Prrromanssss/iTablet/README.md

# iTablet

## Содержание

* [ВВЕДЕНИЕ](#введение)
* [ПЕРВЫЙ ЭТАП](#первый-этап)
  * [1.1 Влияние факторов, ограничивающих социальную коммуникацию](#11-влияние-факторов-ограничивающих-социальную-коммуникацию)
  * [1.2.  Проблематика и анализ доступных технологий для создания прототипа портативного устройства](#12-проблематика-и-анализ-доступных-технологий-для-создания-прототипа-портативного-устройства)
* [ВТОРОЙ ЭТАП](#второй-этап)
  * [2.1. Определение ресурсных затрат](#21-определение-ресурсных-затрат)
  * [2.2. Процесс создания прототипа портативного устройства для социальной коммуникации](#22-процесс-создания-прототипа-портативного-устройства-для-социальной-коммуникации)
  * [2.3. Демонстрация сборки и возможного практического применения прототипа](#23-демонстрация-сборки-и-возможного-практического-применения-прототипа)
  * [2.4. Возможное развитие и совершенствование прототипа.](#24-возможное-развитие-и-совершенствование-прототипа)
    * [2.4.1. Программно-аппаратные доработки](#241-программно-аппаратные-доработки)
    * [2.4.2. Расширение сфер применения](#242-расширение-сфер-применения)
    * [2.4.3. Апробация устройства](#243-апробация-устройства)
* [ВЫВОДЫ](#выводы)
* [ЛИТЕРАТУРА](#литература)
* [ПРИЛОЖЕНИЯ](#приложения)

## ВВЕДЕНИЕ

Речь ― *уникальный* инструмент коммуникации, присущий человеку, значение которого имеет важную роль в гармоничном развитии ребёнка. Через связь с окружающим миром дети учатся базовым социальным навыкам. Она способствует правильному развитию личности, способности к обучению сложным познавательным функциям. Учёные и педиатры выяснили, что отставание в речевом развитии ребёнка нередко сопровождается отставанием общего уровня развития. Механизм речи относится к высшим психическим функциям человека и напрямую зависит от развития центральной нервной системы (ЦНС).

К сожалению, существуют множество факторов, которые могут повлиять на способность ребёнка говорить. Педиатры выделяют следующие причины: патологии беременности и родов, генетические факторы, нарушения работы органа слуха, отсутствие или недостаток социального общения и воспитания. И если некоторые из них могут поддаваться лечению и терапии, то прочие навсегда способны полностью или частично лишить человека способности говорить.

Нарушения коммуникативных функций создают большие трудности в повседневной жизни для ребёнка и его близких. В ряде случаев ребёнок не способен ясно изложить просьбу в удовлетворении базовых физиологических потребностей. Отсюда возникает проблема в поиске средств коммуникации между ребёнком и взрослыми.

В эпоху повсеместного развития цифровой индустрии, в качестве доступного решения проблемы могут выступать портативные программируемые устройства, способные к модификации с учётом индивидуальных особенностей ребёнка.

Новизна обусловлена применением современных портативных устройств на основе бюджетных моделей для детей, испытывающих трудности социального взаимодействия.

Актуальность исследования заключается в возможности применения современных портативных электронных устройств на базе программируемых микроконтроллеров с визуально-звуковым подкреплением.

Целью работы является исследование технологий создания современных электронных устройств для детей, испытывающих трудности социального взаимодействия.

**Задачи проекта:**

* исследовать факторы, ограничивающих гармоничное развитие и оказывающих влияние на социальную коммуникацию детей и взрослых;
* проанализировать доступные технологии создания современных электронных устройств с визуально-звуковым подкреплением для детей, испытывающих трудности социальной коммуникации;
* описать процесс создания портативного электронного устройства на базе программируемого микроконтроллера;
* продемонстрировать возможное практическое применение прототипа.

На первом этапе исследуем факторы, ограничивающие гармоничное развитие и оказывающие влияние на социальную коммуникацию детей и взрослых и проанализируем доступные технологии создания портативных устройств, способных выступать инструментом социальной коммуникации.

На втором этапе опишем процесс создания электронного устройства на базе программируемого микроконтроллера и продемонстрируем возможное практическое применение прототипа.

## ПЕРВЫЙ ЭТАП

### 1.1 Влияние факторов, ограничивающих социальную коммуникацию

 Специалисты уверены, что задержка или отсутствие речевого развития у детей не является самостоятельным заболеванием. Механизм речи напрямую зависит от развития центральной нервной системы.

**Некоторые факторы, провоцирующие задержку речевого и психоречевого развития:**

* Болезни матери во время беременности. Нарушению развития плода могут способствовать проникновению инфекции, отравления, травмы.
* Кислородное голодание (гипоксия) плода в утробе матери.
* Тяжелые роды (стремительные, преждевременные, обвитие пуповины вокруг шеи), травма ребенка при родах (перинатальная энцефалопатия, травма ЦНС, шейных отделов позвоночника).
* Перенесение ребенком тяжелых инфекций (вызвавших заболевания мозга) и травм в раннем возрасте.
* Генетические, хромосомные заболевания, при которых нарушается структура мозга.
* Неправильное воспитание: ребенок растет под слишком сильной опекой или, наоборот, брошен на произвол судьбы, с ребенком дома жестоко обращаются. Нередко дети с ЗПРР выходят из асоциальных семей.
* Тяжелая психическая травма в раннем возрасте.

**Заболевания, провоцирующие задержку речевого и психоречевого развития:**

* врожденные аномалии ЦНС;
* эпилепсия и другие неврологические заболевания;
* ишемия головного мозга;
* гидроцефалия;
* повышенное внутричерепное давление;
* детский церебральный паралич;
* опухоль головного мозга;
* патологии сосудов головного мозга;
* лейкодистрофии;
* нарушение ликвородинамики.

Кроме того, не являются исключением и расстройства аутистического спектра.

Из всего вышеперечисленного видно, что существует множество факторов ограничивающих социальную коммуникацию ребёнка, а значит возникает потребность в комплексной поддержке специалистов и исследованиях возможности применения современных технологий и средств, компенсирующих данное явление.

### 1.2.  Проблематика и анализ доступных технологий для создания прототипа портативного устройства

Анализируя рынок устройств для альтернативной коммуникации детей, испытывающих трудности социального взаимодействия, нами были выявлены **ряд проблем**. К которым можно отнести:

* ценовой сегмент, не предлагающий бюджетных решений (устройства на основе планшетных компьютеров);
* возможность использования на таких устройствах приложений для развлечений, упреждающих возможность к быстрой коммуникации;
* нежелательное поведение без присмотра, актуальное для дорогостоящих устройств, имеющих выход в сеть интернет;
* способность к модификации с учётом индивидуальных особенностей ребёнка.

Примером такого устройства можно считать планшет-коммуникатор Tobii Dynavox Indi. Устройство представлено в высоком ценовом сегменте и является адаптивным планшетным компьютером.

В качестве решения данной проблемы, опишем возможность создания прототипа на основе доступных современных технологий.

За основу функционального устройства была выбрана форма планшета с матрицей кнопок (*Рисунок 1*). Каждая из кнопок содержит графическое изображение, отражающее базовую потребность (визуальное подкрепление) и голосовое дублирование (звуковое подкрепление).

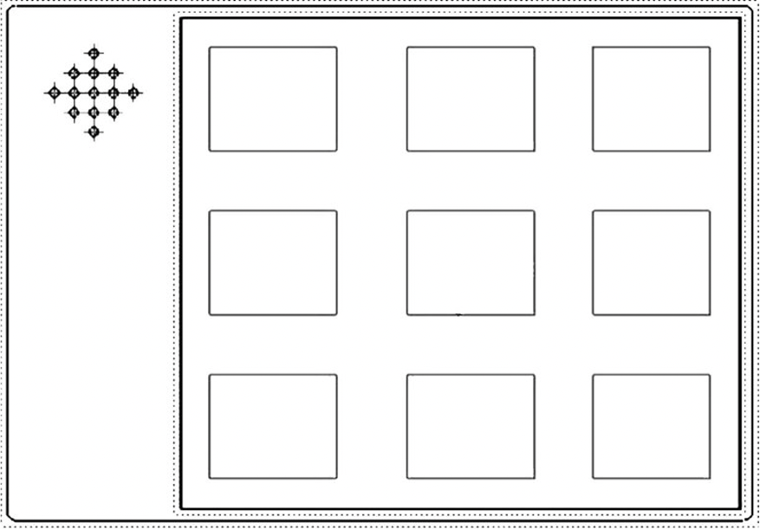
[picture p1: images/design_sketch.png]
Эскиз конструкции прототипа


<p align=center><i>Рис. 1. Эскиз конструкции прототипа</i></p>

Для создания устройства данного типа необходимо определить среду разработки. Остановим наш выбор на Arduino. Наш выбор обусловлен доступностью, обширным количеством документации и библиотек. Данная среда разработки поддерживает множество различных программно-аппаратных решений на основе программируемых микроконтроллеров.

Для расширения функционала и обеспечения удалённой коммуникации, в качестве примера, было решено дополнить устройство возможностью дублировании команд в популярном мессенджере. Чтобы воплотить данную задачу было решено использовать плату типа ESP8266. Её функционал позволяет осуществлять связь между устройствами по средствам локальных персональных сетей с использованием технологии Wi-Fi.

Плата ESP8266 имеет **несколько модификаций**:

* Wemos D1 mini;
* Wemos D1 R2;
* Wemos D1 R1.

Наиболее популярной версией является R2. Стоимость R1 немного ниже. Отличие первого от второго поколения не очень большие и касаются, в первую очередь, распиновки, однако обе модели подходят под наше устройство. По сравнению с Wemos D1 R1/R2, микроконтроллер WeMos D1 Mini имеет меньшие габариты, что сказалось на распиновке, которая не подходит для нашего устройства из-за маленького количества цифровых контактов. Чтобы выполнить все задачи, поставленные в проекте, было решено использовать Wemos D1 R1, выбор обусловлен доступностью.

Для обеспечения заявленного звукового подкрепления необходимо наличие звукового модуля. Среди популярных решений можно встретить следующие **модели**:

* модуль wtv020sd16p, поддерживающий карты памяти microSD объёмом до 2 гигабайт и имеющий ограничения в чтении популярных форматов аудиофайлов. Мало популярный формат .ad4 требует необходимости в использовании дополнительного программного обеспечения для конвертации звуковых файлом;
* модуль DFPlayer mini mp3, поддерживающий популярный стандарт расширения .mp3, поддерживающий карты памяти объёмом до 32 гигабайт и объективную файловую систему типа FAT.

*Очевидно*, что модуль DFPlayer преимущественно выгоднее своего аналога wtv020sd16p.

 В качестве звуковоспроизводящего устройства подойдёт любой аудио-динамик (спикер) заявленной мощностью 0.5W 8 Ом и радиусом 50мм.

Выбор мессенджера, обеспечивающего удалённую коммуникацию, не является принципиальным вопросом, поскольку роль его сводится лишь в дублировании команд, отправляемых с портативного устройства. В нашей работе был выбран популярный мессенджер Telegram, предлагающий большой функционал и удобный способ разработки.

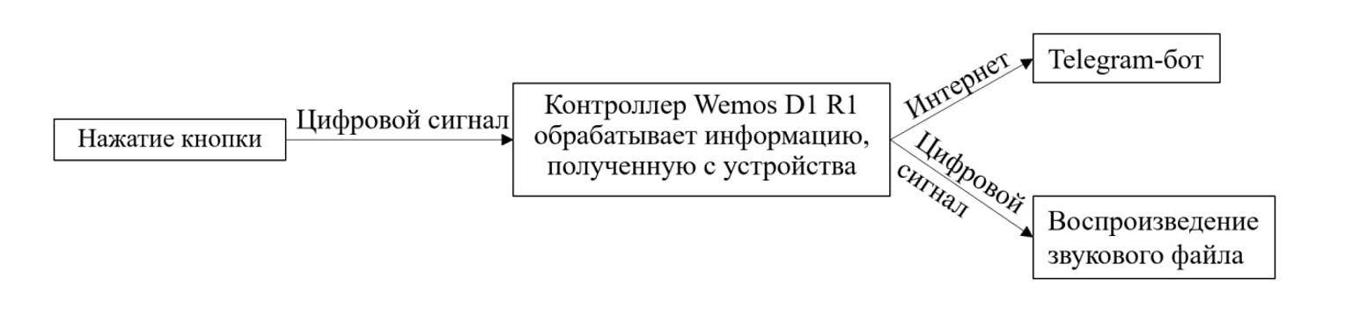
[picture p2: images/data_transmission_scheme.png]
Схема передачи данных


<p align=center><i>Рис. 2. Схема передачи данных</i></p>

## ВТОРОЙ ЭТАП

### 2.1. Определение ресурсных затрат

Корпус и механические части изделия были созданы с использованием технологии послойной 3D печати пластиком типа PLA с диаметром нити 1,75 миллиметров. С описание печатных элементов изделия можно ознакомиться в *Приложении 1*.

Питание микроконтроллера будет осуществляться с помощью литий-полимерного аккумулятора на 5В. Его емкость составляет 5000 мАч. Данного объёма хватит для продолжительной работы устройства.

Со списком необходимых электронных деталей можно ознакомиться в *Приложении 2*.

<p align=right><i>Таблица стоимости деталей</i></p>

<p align=center>
    <table>
        <tr>
            <th>Номер</th>
            <th>Элемент</th>
            <th>Цена</th>
        </tr>
        <tr>
            <th>№ 1</th>
            <th>Плата WeMos D1 R1 с программируемым микроконтроллером ESP8266;</th>
            <th>300 ₽</th>
        </tr>
        <tr>
            <th>№ 2</th>
            <th>Звуковой модуль DFPlayer Mini MP3 3,5V;</th>
            <th>200 ₽</th>
        </tr>
        <tr>
            <th>№ 3</th>
            <th>Карта памяти microSD для хранения файлов, используемых DFPlayer Mini MP3;</th>
            <th>300 ₽</th>
        </tr>
        <tr>
            <th>№ 4</th>
            <th>Соединительные провода;</th>
            <th>400 ₽</th>
        </tr>
        <tr>
            <th>№ 5</th>
            <th>Тактовая кнопка, 8 штук;</th>
            <th>650 ₽</th>
        </tr>
        <tr>
            <th>№ 6</th>
            <th>Аудио-динамик 0.5W 8Ом 50мм;</th>
            <th>150 ₽</th>
        </tr>
        <tr>
            <th>№ 7</th>
            <th>Резисторы 2-2.2 кОм;</th>
            <th>50 ₽</th>
        </tr>
        <tr>
            <th>№ 8</th>
            <th>Литий-полимерный аккумулятор 5 В, 1.5 А, 5000 мАч для питания WeMos D1 R1;</th>
            <th>1000 ₽</th>
        </tr>
        <tr>
            <th>№ 9</th>
            <th>Переключатель движковой SS12D10;</th>
            <th>50 ₽</th>
        </tr>
        <tr>
            <th>№ 10</th>
            <th>Пластик.</th>
            <th>800 ₽</th>
        </tr>
    </table>
</p>

*Итого: 3900 ₽*

### 2.2. Процесс создания прототипа портативного устройства для социальной коммуникации

Для моделирования электрической схемы устройства воспользуемся сервисом KiCad (*Рисунок 3*). Этот сервис совмещает в себе возможность просмотра, создания и редактирования печатных плат. Среди аналогов является самым популярным и используемым. Для создания электрический схемы предоставляет весь необходимый функционал.

Далее, необходимо выполнить загрузку программного обеспечения, выполняющего управление работой платы WeMos D1 R1. Так как система Arduino-совместима, то все ее программирование будет проходить в среде разработки Arduino IDE. Для работы со звуковым модулем необходимо установить библиотеку Software.Serial, обеспечивающую прием и передачу данных от платы к модулю (порты RX и TX соответственно), а также библиотеку DFPlayerMini_Fast для инициализации модуля и воспроизведение файлов.

С листингом кода программы можно ознакомиться в файле iTablet_soft.ino.

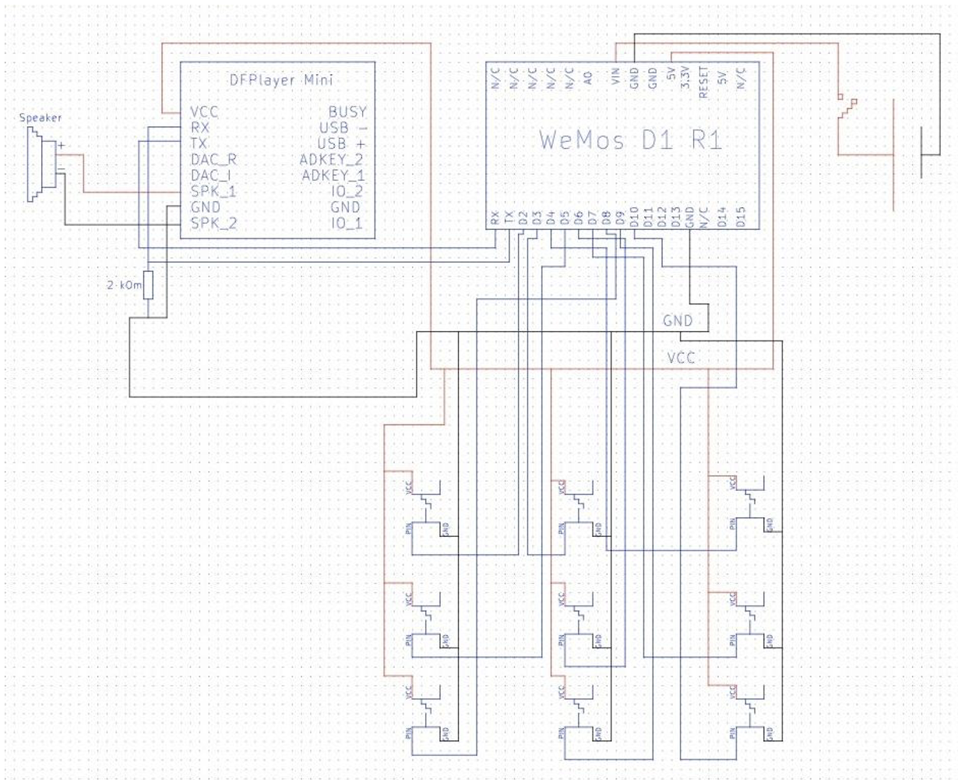
[picture p3: images/principal_scheme.png]
Принципиальная схема устройства


<p align=center><i>Рис. 3. Принципиальная схема устройства</i></p>

### 2.3. Демонстрация сборки и возможного практического применения прототипа

Руководствуясь принципиальной схемой, выполним сборку электронных элементов устройства (*Рисунок 4*).

Для питания платы соединим ее с аккумулятором, далее подготовим звуковой модуль для подключения к WeMos D1 R1. Для этого нам потребуется припаять плюс и минус динамика к соответствующим пинам модуля DFPlayer Mini MP3.

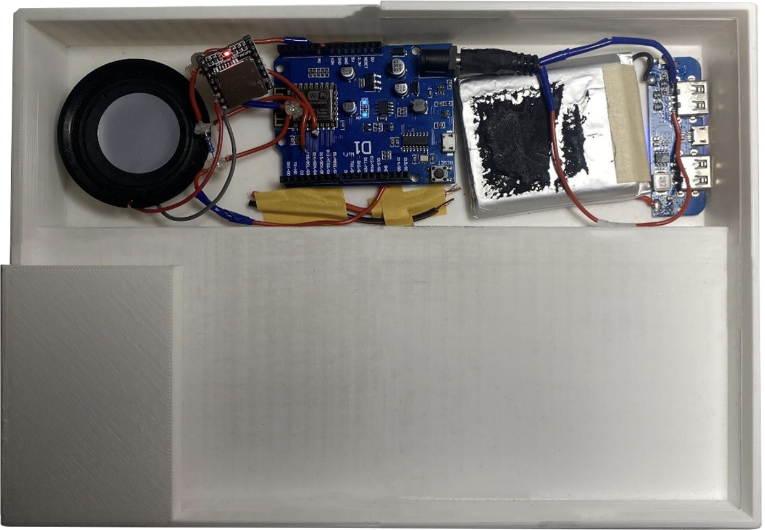
[picture p4: images/connection_of_the_module_boards_to_the_battery.png]
Соединение плат и модулей с элементом питания


<p align=center><i>Рис. 4. Соединение плат и модулей с элементом питания</i></p>

После соединим RX, TX модуля с RX, TX платы, соединим линию питания с WeMos D1 R1, припаяв соответствующие контакты.

Расположим плату и звуковой модуль с аккумулятором в нижнем основании корпуса. Поместив кнопки в ячейки, останется припаять контакт PIN у кнопок к цифровым пинам платы, и GND с 5 V в соответствующие провода. Закрепим эти детали сверху (*Рисунок 5*).

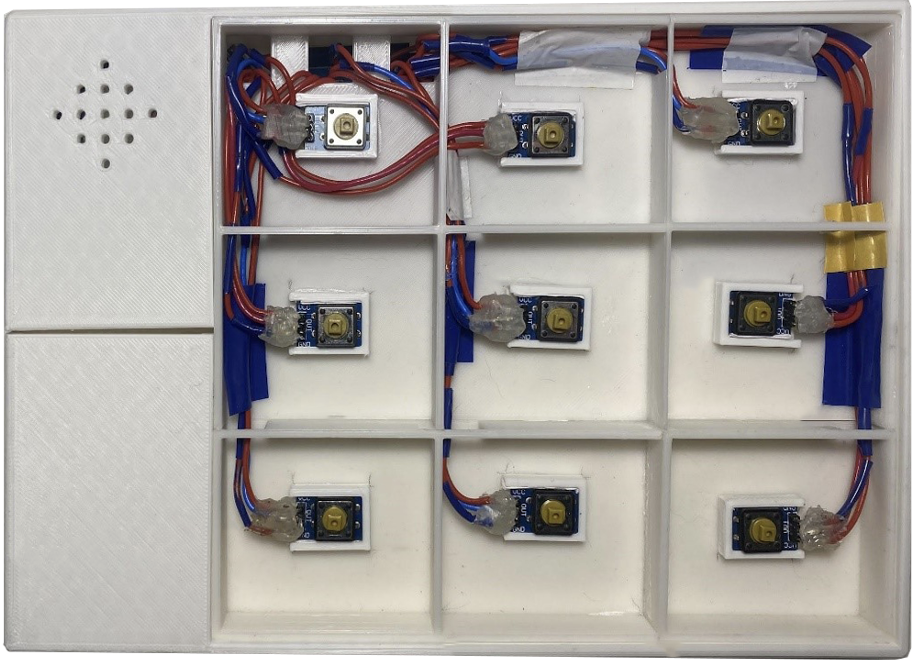
[picture p5: images/position_of_the_device_buttons.png]
Положение кнопок устройства


<p align=center><i>Рис. 5. Положение кнопок устройства</i></p>

Расположим изображения, которая будет иллюстрировать функционал каждой кнопки и закрепим (*Рисунок 6*).

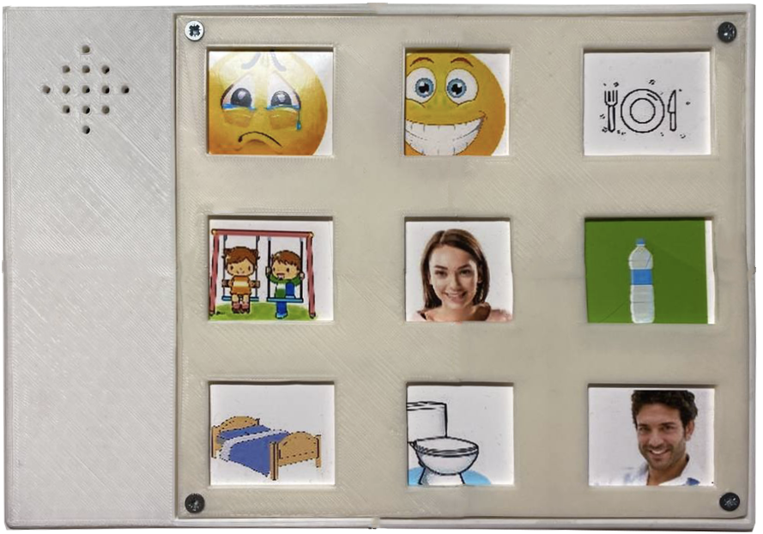
[picture p6: images/appearance_of_the_prototype.png]
Вариант внешнего вида прототипа


<p align=center><i>Рис. 6. Вариант внешнего вида прототипа</i></p>

С результатами проводимых тестов можно ознакомиться в видео по [ссылке](https://youtu.be/9zQaclMQYKQ):

### 2.4. Возможное развитие и совершенствование прототипа.

#### 2.4.1. Программно-аппаратные доработки

Так как к нашему устройству подключен телеграм бот, то планшет должен быть подключен к Wi-Fi, для этого необходимо знать имя сети и пароль от нее. На данном этапе, все эти данные мы вводим в программное обеспечение, в среде разработки IDE Arduino. Чтобы ввод данных был удобнее и каждый мог это сделать, мы решили подключить к нашему прототипу сервис RemoteXY. Он представляет из себя систему разработки и использования мобильных графических интерфейсов для управления контроллерами со смартфона или планшета. Благодаря ему, пользователь сможет вводить на своем телефоне все необходимые данные, а они, в свою очередь, будут отправлять на плату.

#### 2.4.2. Расширение сфер применения

В нашем проекте, мы предлагаем возможное решение проблемы коммуникации детей с ограниченными возможностями, но также можно расширить сферу применения, а именно:

* помощь людям, находящимся на длительном лечении или реабилитации. Мы предлагаем использовать данное устройство для связи с персоналом больницы;
* применение устройства в домах престарелых. Данный пункт является аналогом предыдущего

#### 2.4.3. Апробация устройства

В планах улучшения данного проекта стоит **апробация**:

* Изучение плюсов и минусов планшета на практике;
* Впечатление законных представителей о данном устройстве.

На данном этапе идут переговоры о возможности применения и тестирования прототипа в следующих организациях:

* Дошкольное подразделение государственной бюджетной общеобразовательной школы № 109;
* Государственное бюджетное учреждение здравоохранения города Москвы "Морозовская детская городская клиническая больница Департамента здравоохранения города Москвы".

## ВЫВОДЫ

В ходе исследования была поставлена цель работы и решены несколько задач.

На первом этапе были исследованы факторы, ограничивающие гармоничное развитие и оказывающие влияние на социальную коммуникацию детей и взрослых и проанализированы доступные технологии создания портативных устройств, способных выступать инструментом социальной коммуникации.

Подводя итоги первого этапа исследования, мы предложили возможное решение проблемы — создание собственного прототипа устройства для коммуникации детей с особенностями речевого развития.

На втором этапе описали процесс создания электронного устройства на базе программируемого микроконтроллера и продемонстрировали возможное практическое применение прототипа.

## ЛИТЕРАТУРА

Doheny K. // Использование iPad для комментирования повышало эффективность терапии для развития речи [Электронный ресурс](https://medicalxpress.com/news/2014-07-ipads-boost-skills-kids-autism.html#nRlv)

Асмолова Г.А, / Ранняя диагностика нарушений развития речи. Особенности речевого развития у детей с последствиями перинатальной патологии нервной системы / Асмолова Г.А, Заваденко А.Н., [и др.] / Клинические рекомендации Российской академии наук. – М: РАН, 2015. – 35с.

Е.А. Стребелева, Г.А. Мишина. Психолого-педагогическая диагностика нарушений развития детей раннего и дошкольного возраста. Учебное пособие. – М.: Мозаика-Синтез, 2016. – 200 с.

Нейробиологические основы возникновения и восстановительного лечения перинатального поражения центральной нервной системы у детей. – М.: ПедиатрЪ, 2016. – 184 с.

## ПРИЛОЖЕНИЯ

<p align=right><strong>Приложение 1.</strong></p>
<p align=right><i>Таблица 1. Печатные детали прототипа</i></p>

<p align=center>
    <table>
        <tr>
            <th>№ п/п</th>
            <th>Описание назначения компонента</th>
            <th>Изображения детали</th>
        </tr>
        <tr>
            <th>1.</th>
            <th>Верхняя крышка корпуса, составная;</th>
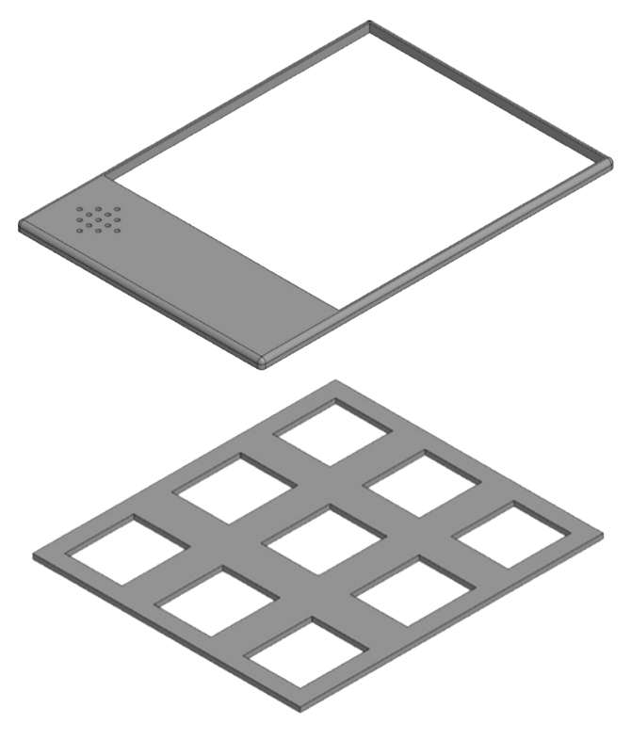
[picture p7: images/annex_1/upper_case_cover.png]
            <th></th>
        </tr>
        <tr>
            <th>2.</th>
            <th>Ячейки расположения кнопок;</th>
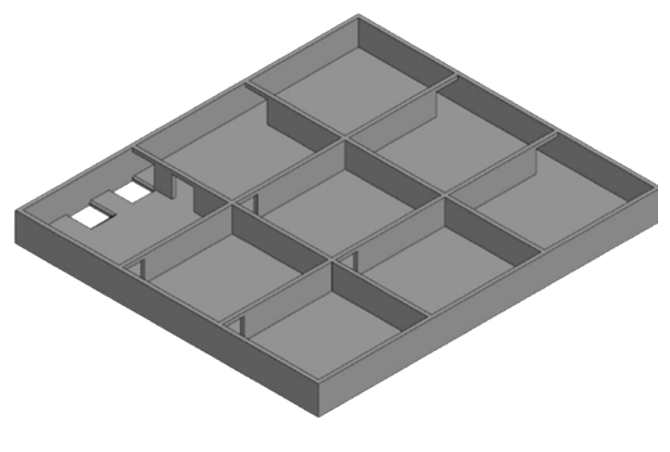
[picture p8: images/annex_1/button_location_cells.png]
            <th></th>
        </tr>
        <tr>
            <th>3.</th>
            <th>Нижнее основание корпуса;</th>
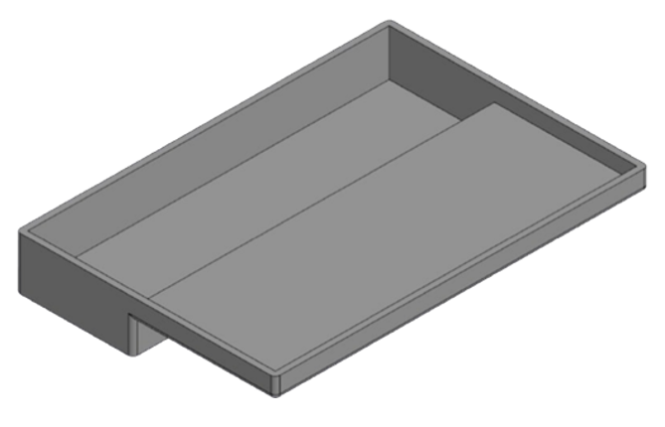
[picture p9: images/annex_1/lower_case_base.png]
            <th></th>
        </tr>
        <tr>
            <th>4.</th>
            <th>Нажимная платформа кнопки;</th>
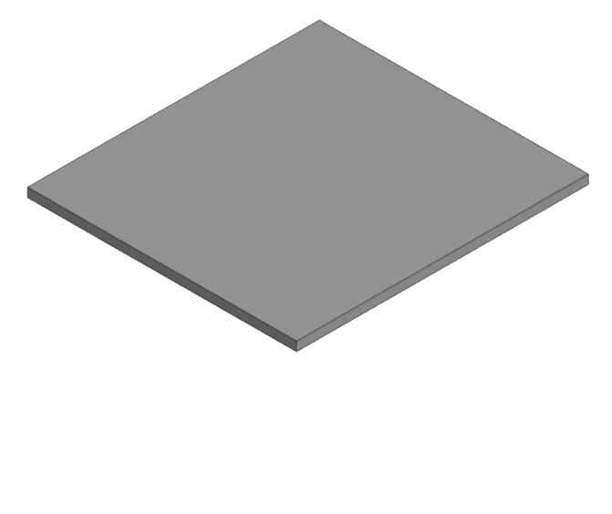
[picture p10: images/annex_1/push_button_platform.png]
            <th></th>
        </tr>
        <tr>
            <th>5.</th>
            <th>Фиксатор кнопки к основанию корпуса;</th>
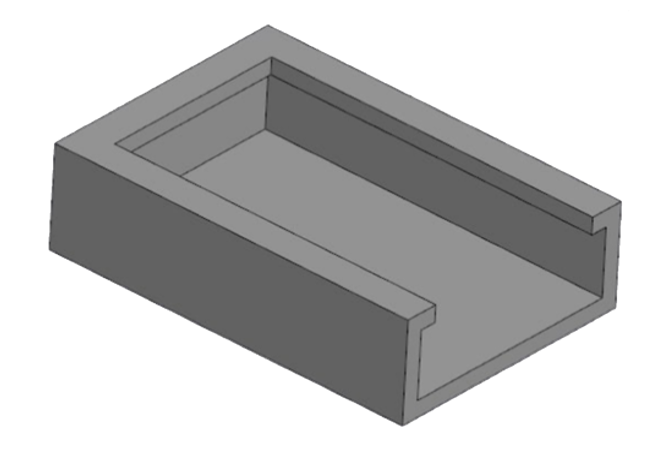
[picture p11: images/annex_1/button_retainer_to_case_base.png]
            <th></th>
        </tr>
        <tr>
            <th>6.</th>
            <th>Фиксатор звукового динамика.</th>
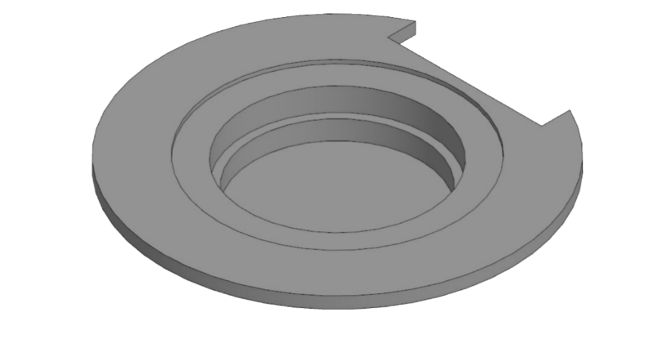
[picture p12: images/annex_1/audio_speaker_retainer.png]
            <th></th>
        </tr>
    </table>
</p>

<p align=right><strong>Приложение 2.</strong></p>
<p align=right><i>Таблица 2. Электронные детали прототипа</i></p>

<p align=center>
    <table>
        <tr>
            <th>№ п/п</th>
            <th>Описание назначения компонента</th>
            <th>Изображения детали</th>
        </tr>
        <tr>
            <th>1.</th>
            <th>Плата WeMos D1 R1 с программируемым микроконтроллером ESP8266;</th>
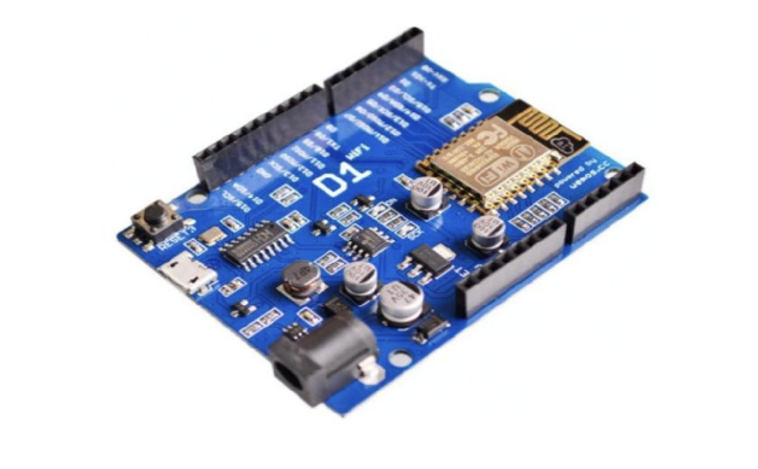
[picture p13: images/annex_2/WeMos_D1_R1.png]
            <th></th>
        </tr>
        <tr>
            <th>2.</th>
            <th>Звуковой модуль DFPlayer Mini MP3 3,5V;</th>
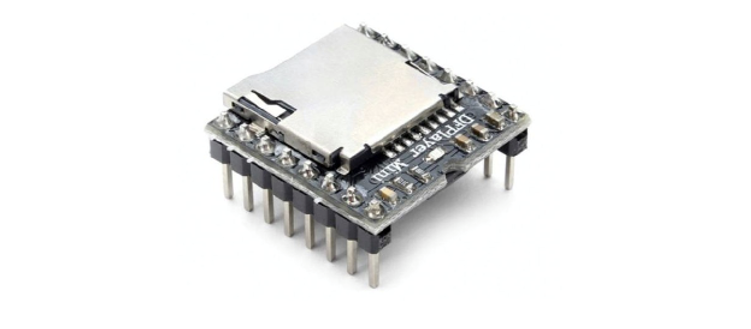
[picture p14: images/annex_2/DFPlayer_Mini_MP3.png]
            <th></th>
        </tr>
        <tr>
            <th>3.</th>
            <th>Соединительные провода;</th>
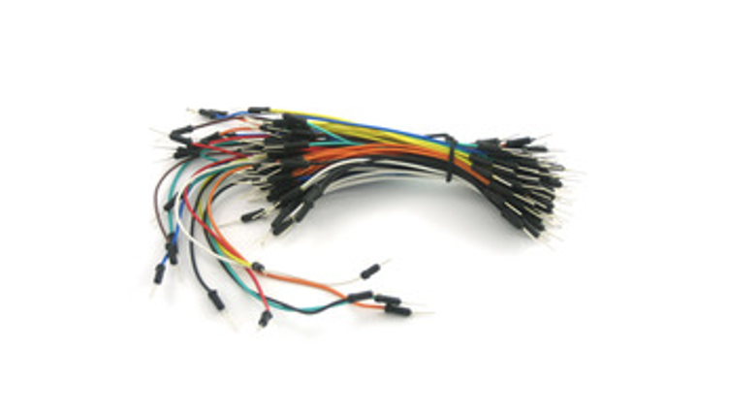
[picture p15: images/annex_2/connecting_wires.png]
            <th></th>
        </tr>
        <tr>
            <th>4.</th>
            <th>Карта памяти microSD для хранения файлов, используемых DFPlayer Mini MP3;</th>
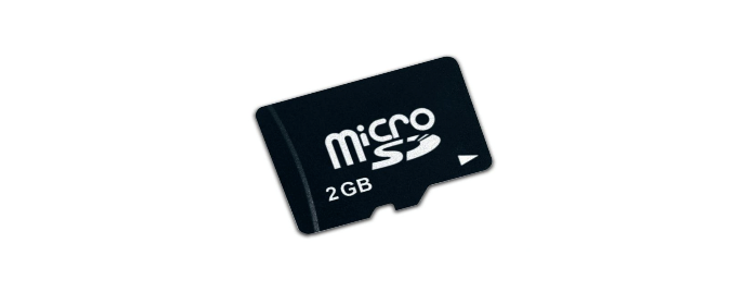
[picture p16: images/annex_2/microSD.png]
            <th></th>
        </tr>
        <tr>
            <th>5.</th>
            <th>Тактовая кнопка;</th>
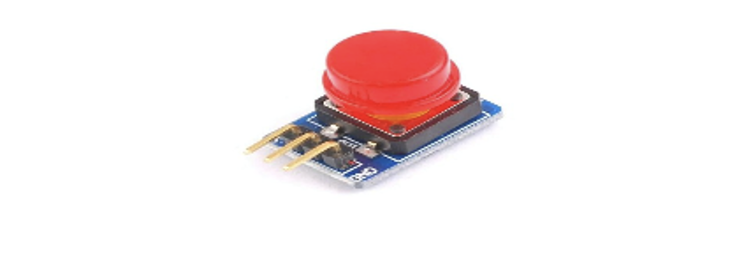
[picture p17: images/annex_2/tact_button.png]
            <th></th>
        </tr>
        <tr>
            <th>6.</th>
            <th>Аудио-динамик 0.5W 8Ом 50мм;</th>
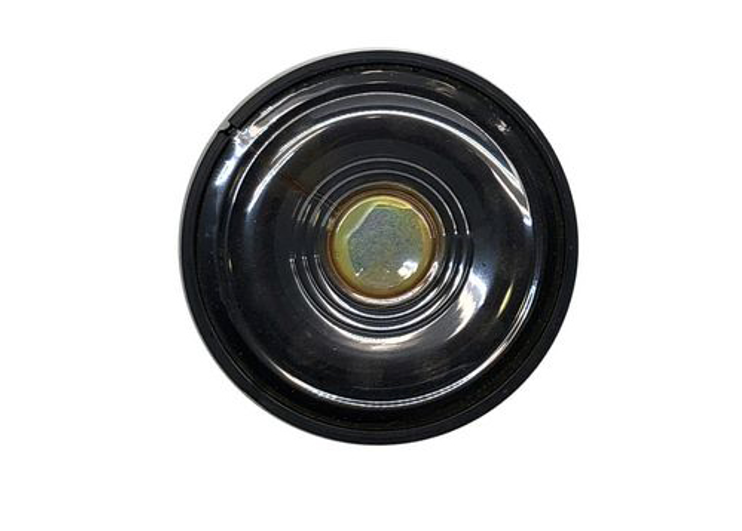
[picture p18: images/annex_2/audio_speaker.png]
            <th></th>
        </tr>
        <tr>
            <th>7.</th>
            <th>Резисторы 2-2.2 кОм;</th>
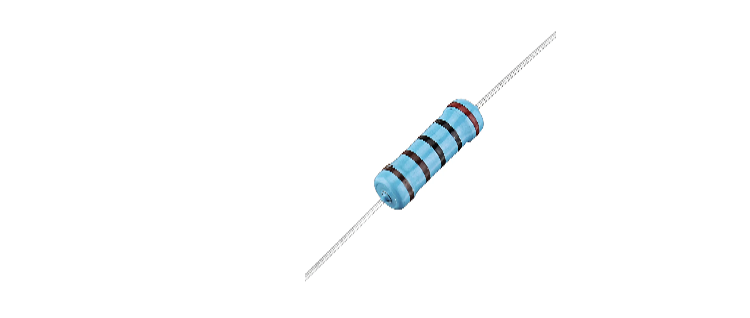
[picture p19: images/annex_2/resistors.png]
            <th></th>
        </tr>
        <tr>
            <th>8.</th>
            <th>Литий-полимерный аккумулятор 5 В, 1.5 А, 5000 мАч для питания WeMos D1 R1;</th>
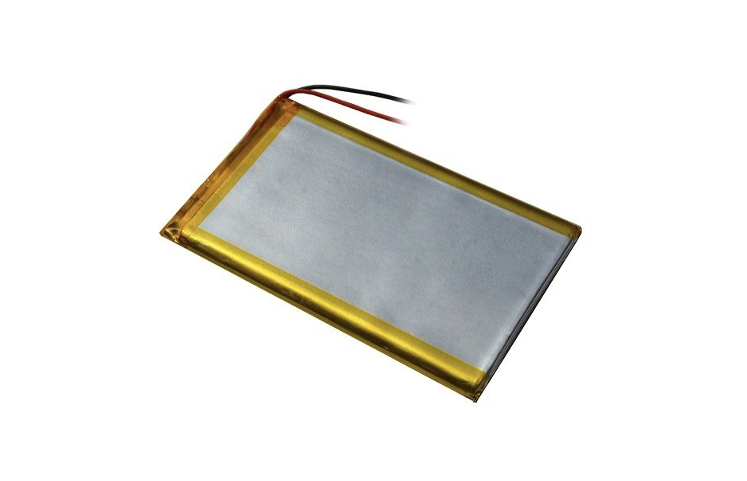
[picture p20: images/annex_2/battery.png]
            <th></th>
        </tr>
        <tr>
            <th>9.</th>
            <th>Движковой переключатель SS12D10.</th>
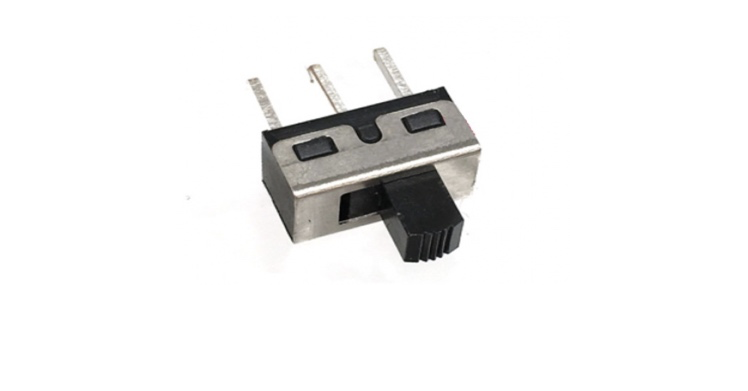
[picture p21: images/annex_2/SS12D10.png]
            <th></th>
        </tr>
    </table>
</p>
